FOSSASystems/FOSSASAT-2/README.md

<h1 align="center">FOSSASAT-2</h1>
<div align="center">

<i>A flexible and integrated 2P PocketQube platform designed for LEO constellations and demonstrator missions.</i>










<!-- <img src="http://hits.dwyl.com/FOSSASystems/FOSSASAT-2.svg" alt="Hits Badge"/> -->

<i>Loved the project? Please consider giving a Star ⭐️ to help it improve!</i>

</div></div>
</div>

GIF
GIF
GIF
GIF

<br>

## [Doxygen Documentation](https://fossasystems.github.io/FOSSASAT-2)

First generation 2P Satellite dedicated to demonstrating new miniaturized technology for picosatellites developed by FOSSA. Launched aboard a Firefly Alpha launch vehicle on the maiden flight with an unfortunate explosion. The satellite was recovered, and on a later launch, a FOSSASAT-1B was successfully placed in orbit by a Firefly Alpha. 

<br>
GIF 
<br>

## Payload
The main payload of FossaSat-2 is an OV2640 low-resolution CMOS camera. GSD is >50m/pixel. A Skytraq GNSS reciever is being used to test active TLE generation for PocketQubes. GPS Payload Supported by the Galileo Science office.

## ADCS
Active pointing is carried out by using integrated solar panel magnetorquers, 2 16-bit sun sensors and an IMU sensor.

## Comms
An SX1268T Chip is used to establish a Morse, 9k6 GFSK and LoRa Downlink and a LoRa and 9k6 GFSK uplink.

GIF
GIF
