FOSSASystems/FOSSASAT-2/hardware/README.md

# FOSSASAT-2 Hardware
This folder contains all schematic, layout and mechanical files related to FOSSASAT-2.
