FOSSASystems/FOSSASAT-2/software/README.md

# FOSSASAT-2 Software
This folder contains all software related to FOSSASAT-2, on-board or otherwise.
