FOSSASystems/FOSSASAT-2/hardware/Attitude Control/README.md

# ADCS

Three H-Bridges control integrated magnetorquers in each solar panel and an internal Y Axis magnetorquer. An IMU sensor on this board and external sun sensors / panel currents give attitude determination.
