FOSSASystems/FOSSASAT-2/hardware/Internal Board Stack/README.md

# Camera Board
Control FET to turn on Camera when in use.

#Battery Heater Board
Control FET to turn on a resistor when a set of conditions established in the requirements document are met.
