FOSSASystems/FOSSASAT-2/hardware/OBC/README.md

# OBC

STM32L452RE powered OBC with flash storage, SEU and SEL protection and an SX1268T Transciever.
