FOSSASystems/FOSSASAT-2/hardware/Power System/README.md

# EPS

Monitors and controls the input of solar panels, regulated to float charge a Li-Ion NP-BX1 Cell at 4V and regulates a common 3.3V power bus.
