FOSSASystems/FOSSASAT-2/hardware/Solar Panels/README.md

#Solar Panels

Solar panels include a combination of: IXYS Solar Cells, Blocking Diodes, Integrated Magnetorquers, EGSE connectors, Temperature sensors and Sun sensors.
