FOSSASystems/FOSSASAT-2/docs/Software Functional Specification.md

# FOSSASAT-2 Software Functional Specification
The purpose of this document is to keep track of all functional specifications, based on [Software Requirements](https://github.com/FOSSASystems/FOSSASAT-2/blob/master/docs/Software%20Requirements.md). Any Specification(s) that fulfill(s) Software Requirement(s) SHOULD list reference to those Requirement(s).

## Deployment Sequence
1. Once Deployed, The killswitch connects and starts  discharging to cpu or/and charging battery if in sunlight.
2. Check EEPROM if Deploy = 0, if Deploy = 1 go to System Start
3. 1m debug silent (Serial output via STLINK)
4. Satellite waits 25m in Sleep 
5. Check voltage, if under 3.7v: wait until you are charged for a maximum of 12 hours and then deploy. If above 3.7v: Deploy.
5. Send Mosfet deploymen signal 
7. Set EEPROM Deploy = 1
8. System Start

## Battery Charging and Heating
Battery heater is a mosfet control pin

1. When under 5c, battery above 3.9v and Charging current above 100mA: Turn on Battery Heater.
2. When 5c reached: turn off battery heater
3. If battery heater on and battery voltage drops below 3.8 volts: Turn off Battery Heater.
4. If battery heater off due to voltage and, temperature drops below 0c, Turn off MPPT.

## Transmissions and Reception 

## Store & Forward Repeater

## Image Downlink

## System Sleep & Power Saving System
