FOSSASystems/FOSSASAT-2/(threads)

Thread 21 (2020-07-14):

Reference frames error

SergioCdV, 2020-07-14:
In software/FossaSat2/src/ADCS/ADCS/adcs_main.cpp

https://github.com/FOSSASystems/FOSSASAT-2/blob/cfe8c75b2e419ddbf0d7e77a95fb421b0153c93a/software/FossaSat2/src/ADCS/ADCS/adcs_main.cpp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

Solar unit panel reference frame relates to the body-ADCS frame as follows: solar X+ equals ADCS X+, solar Y+ equals body Z + and finally solar Z+ equals ADCS Y+.

[ISODRAWINGFISSASAT_2.pdf](https://github.com/FOSSASystems/FOSSASAT-2/files/4919511/ISODRAWINGFISSASAT_2.pdf)

ADCS frame is the one used for naming within the code, though it is not the one used in the dynamical model. In this sense, ADCS Z+ is renamed X+, X+ goes to Y+ and ADCS Y+ ends up as Z+.

Gipsonek, 2020-07-14:
Ah, I forgot the IMU also doesn't follow the solar panel reference frame. So just to confirm, the correct conversion should be:

solar X+ = ADCS X+
solar Y+ = ADCS Z+
solar Z+ = ADCS Y+

SergioCdV, 2020-07-14:
Yes, you are right

Gipsonek, 2020-07-14:
Thank you, should be fixed in 5030998ef2a5e4d1d9dffd4de540572a26e53f45

Closed 2020-07-14.

Thread 27 (2020-07-22):

Reference frames

SergioCdV, 2020-07-22:
In adcs_main, lines 477-485, talking about the comments above, there's still a mistake when identifying reference frames (solar and ADCS). Solar X+ should be ADCS X+ and solar Z+ should be ADCS Y+.

I don't know if it is just unupdated commenting or code is to be modified also.
[
// Calculate the intensities
  // pulseLength vector follows solar panel reference frame, not ADCS frame!
  // solar X+ = ADCS Y+
  // solar Y+ = ADCS Z+
  // solar Z+ = ADCS X+
  ADCS_CALC_TYPE pulseLength[ADCS_NUM_AXES];
  pulseLength[0] = ACS_IntensitiesRectifier(adcsState.prevIntensity[0], intensity[0], adcsParams.timeStep, adcsParams.pulseAmplitude);
  pulseLength[1] = ACS_IntensitiesRectifier(adcsState.prevIntensity[2], intensity[2], adcsParams.timeStep, adcsParams.pulseAmplitude);
  pulseLength[2] = ACS_IntensitiesRectifier(adcsState.prevIntensity[1], intensity[1], adcsParams.timeStep, adcsParams.pulseAmplitude);](url)

Gipsonek, 2020-07-22:
That's just a case of forgetting to update the comments - the actual assignments are correct, i.e.

intensity[0] -> pulseLength[0] (ADCS X+ -> solar X+)
intensity[2] -> pulseLength[1] (ADCS Z+ -> solar Y+)
intensity[1] -> pulseLength[2] (ADCS Y+ -> solar Z+)

Closed 2020-07-22.

Thread 33 (2020-08-28):

Store and Forward coding

N6RFM, 2020-08-28:
Hi,

In the FS-2 sketch, message store and forwarding is supported by the folling code

case 'b':
 addStoreAndForward(0x1337BEEF, "Hello there!");
 break;

I'm not a programmer, but it appears that 0x1337BEEF is a memory address?  Is there a limit on the numberof characters which may be sent to this address?

Also, please comment on the code below.  This is intended to send a message (up to 32 characters) but unclear to me how to specify the correct memory address.

```c++
//adapted from code provided by K4KDR

String myCall="N6RFM";
String mySFtext="Hello from";

 void sendSF() {

  // get data to be stored and forwarded
  char optData[32];
  // text to transmit + some additional underscores for blank space after
  String cq = mySFtext + myCall + " ";
  // Length (with one extra character for the null terminator)
  int str_len = cq.length() + 1;
  cq.toCharArray(optData, str_len);

  Serial.println();
  Serial.print(F("Sending Store annd Forward text "));

  // data to transmit
  uint8_t functionId = CMD_STORE_AND_FORWARD_ADD;   //unclear how to specify target memory address ?0x1337BEEF
  uint8_t optDataLen = strlen(optData);

  // build frame
  uint8_t len = FCP_Get_Frame_Length(callsign, optDataLen);
  uint8_t* frame = new uint8_t[len];
  FCP_Encode(frame, callsign, functionId, optDataLen, (uint8_t*)optData);

  // send data
  int state = radio.transmit(frame, len);
  delete[] frame;
```

Thanks so much!
Bob N6RFM

Gipsonek, 2020-08-29:
0x1337BEEF is a 4-byte ID for your message, chosen by the user (see the [communication protocol specs](https://github.com/FOSSASystems/FOSSASAT-2/blob/master/docs/Communication%20Protocol.md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)). If you want to request the saved message later, you send the ID and the satellite will return the message with that ID. If you send a message with the same ID, the original one will be overwritten.

The above link also contains information on how to specify the ID (it's the first 4 bytes of optional data), as well as the maximum message length (28 bytes).

N6RFM, 2020-08-29:
Thank you for the explanation.  All Best,  Bob

Closed 2025-07-14.

Thread 36 (2025-07-28):

VEML7700-TR quality

joaosantos44, 2025-07-28:
Hello, my name is Joao Santos. I am currently working on Quetzal 2.

Your sun sensors have caught my attention, and I would like to know if they experienced any obscuration during use, as this is one of the problems we are currently facing. In the previous mission, we used photodiodes, and they did experience obscuration, which caused a drop in the voltage they were monitoring.

I look forward to your response and thank you in advance for replying to this message.
