FOSSASystems/FOSSASAT-2/hardware/OBC/Schematic_FOSSA2OBC_Sheet_1_20191107205757.pdf

PB12 33 PB13 34 PB14 35 PB15 36 PC6 37 PC7 38 PC8 39 PC9 40 PA8 41 PA9 42 PA10 43 PA11 44 PA12 45 PA13(JTMS/SWDIO) 46 VSS 47 VDDUSB 48 PA14⁽JTCK/SWCLK⁾ 49 PA15⁽JTDI) 50 PC10 51

## I2C TEMP. SENSOR

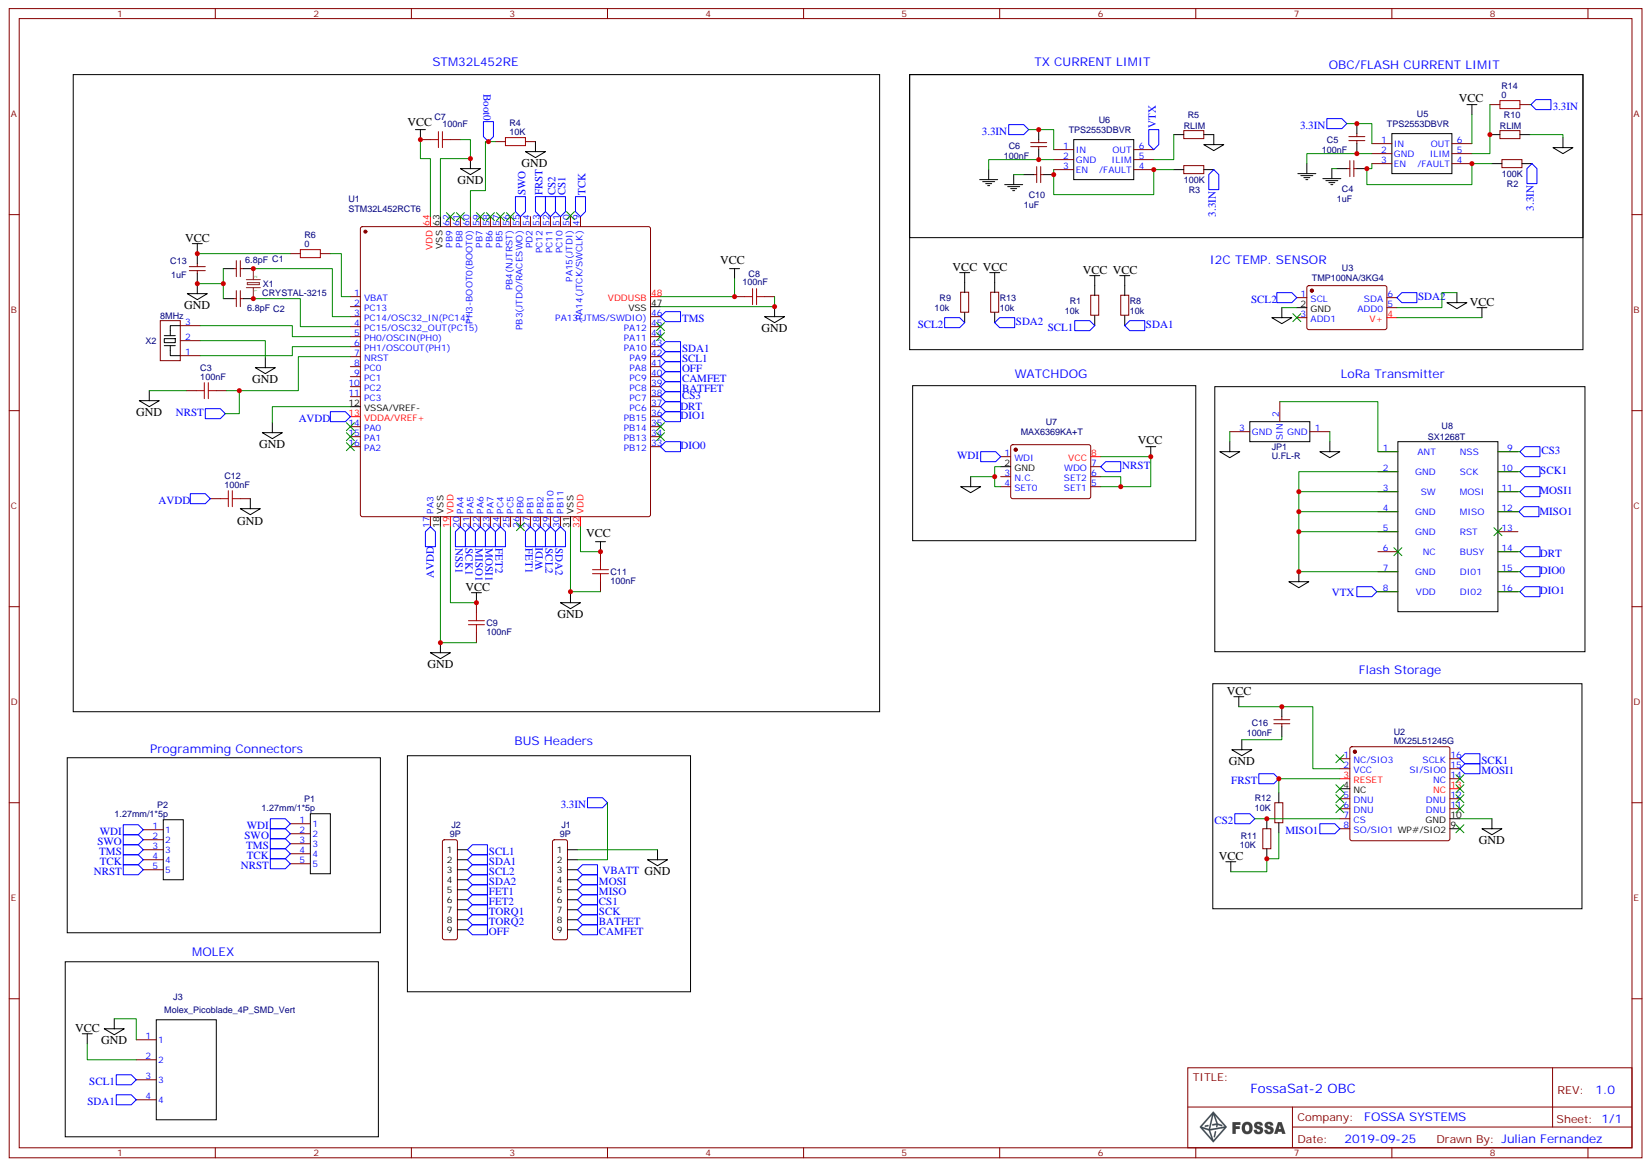
[picture p9: page 1]

OBC/FLASH CURRENT LIMIT

Drawn By: Julian Fernandez
