FOSSASystems/FOSSASAT-2/hardware/Power System/Schematic_FOSSA2MPPT_Sheet_1_20191107205719.pdf

## X AXIS PANEL MPPT

## BUS Headers

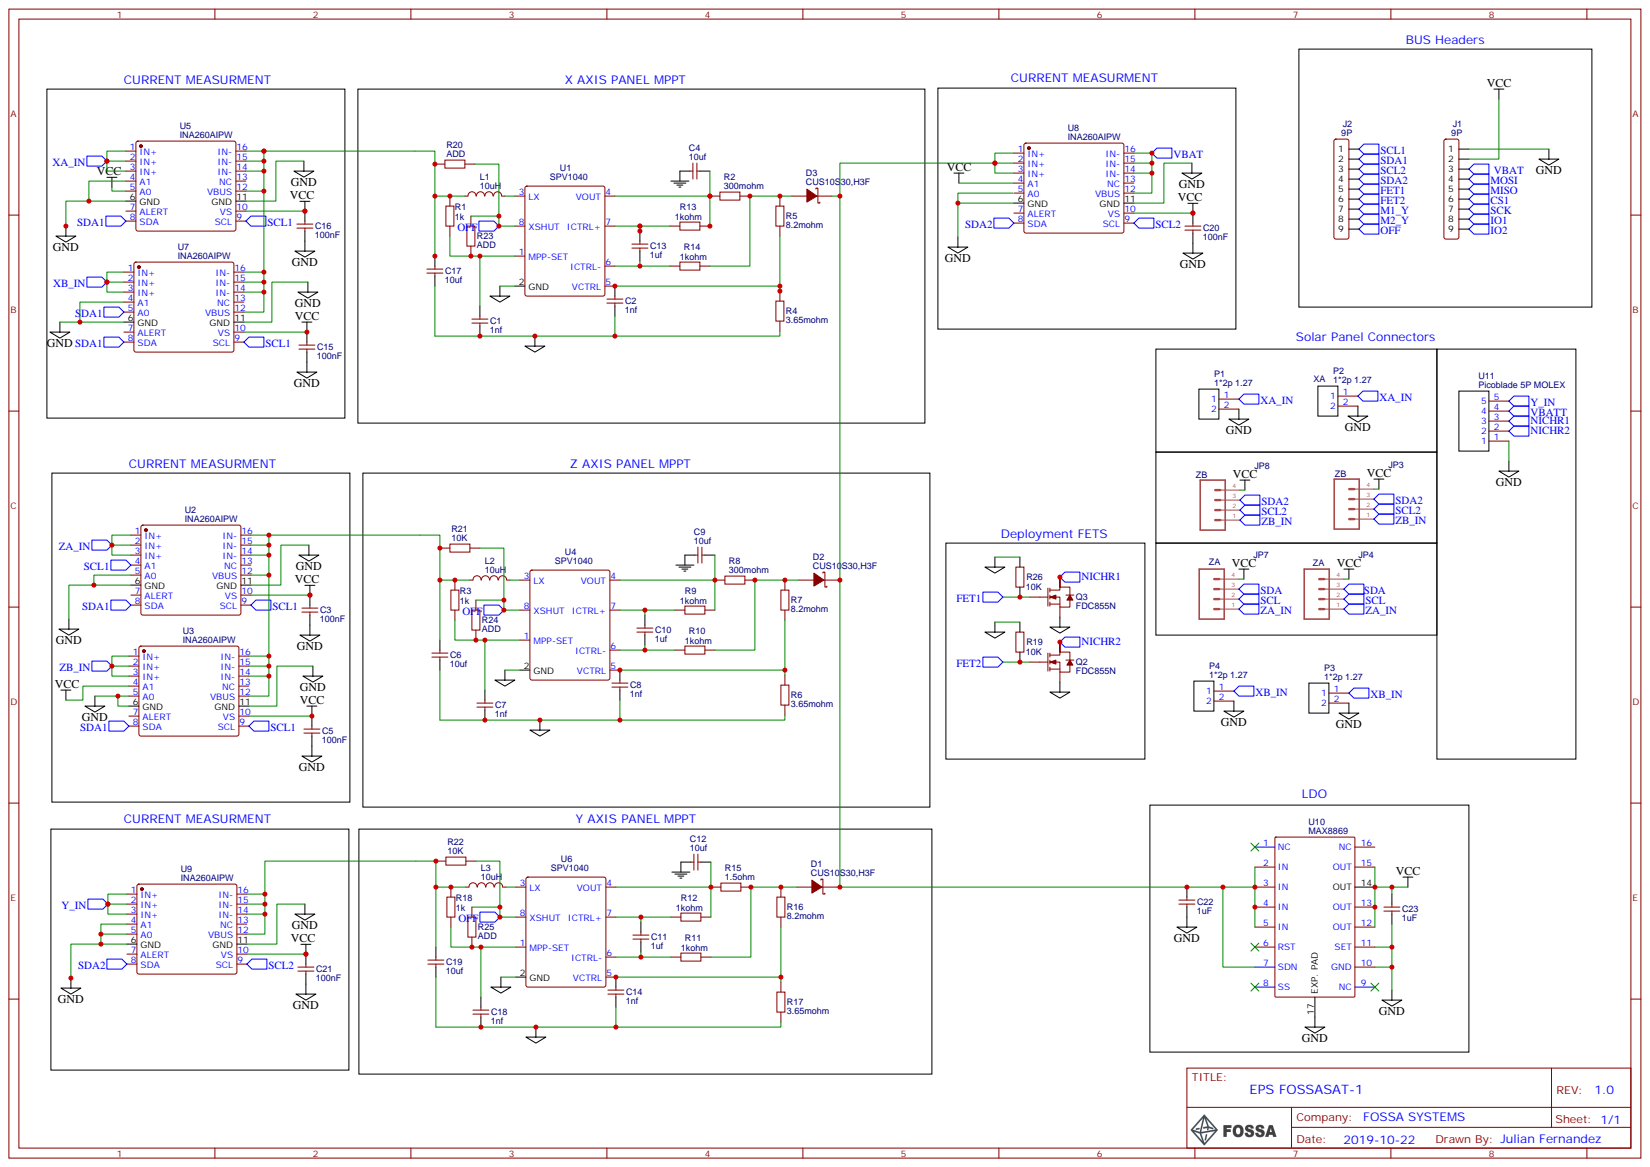
[picture p10: page 1]

INA260AIPW
VS 10 GND 11 VBUS 12 NC 13 IN- 14 IN- 15 IN- 16

Drawn By: Julian Fernandez
