FOSSASystems/FOSSASAT-2/hardware/Attitude Control/Schematic_Internal Boards FOSSASAT_1_Sheet_1_20191107210138.pdf

## BUS Headers

## Solar Panel Headers

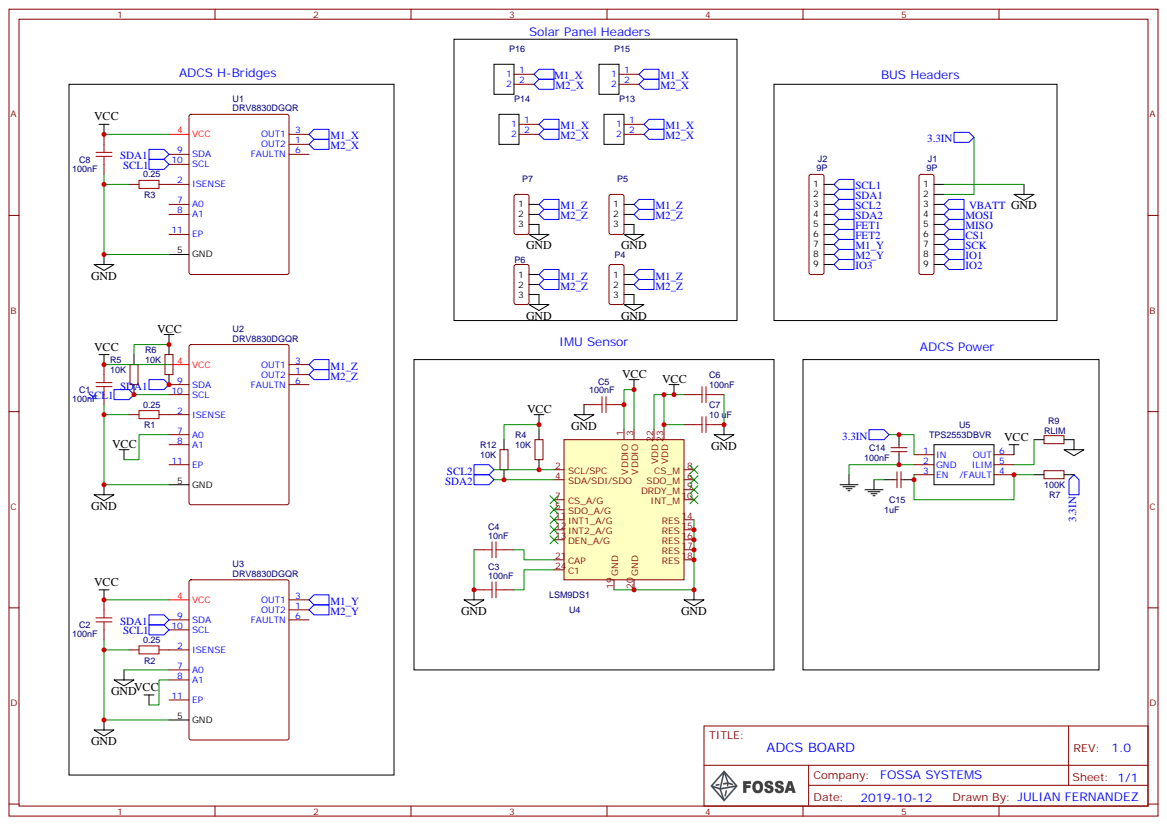
[picture p11: page 1]

Drawn By: JULIAN FERNANDEZ
