FOSSASystems/FOSSASAT-2/hardware/Internal Board Stack/Schematic_battboard_Sheet_1_20191107204911.pdf

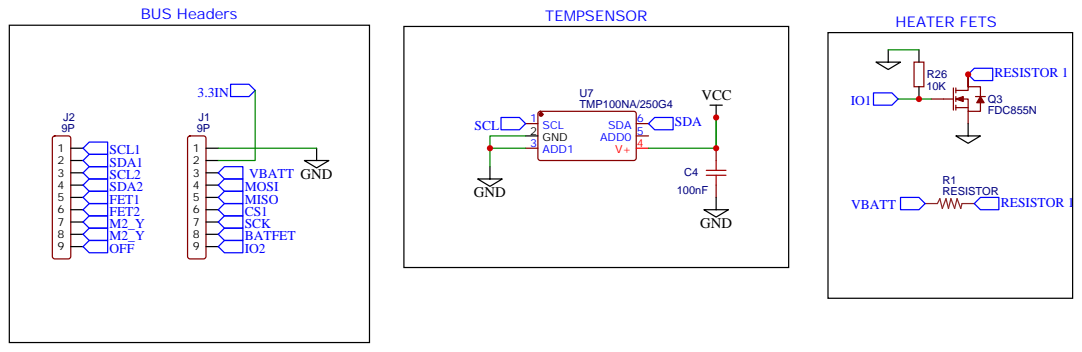
[picture p12: page 1]

Drawn By: Julian Fernandez
