FOSSASystems/FOSSASAT-2/hardware/Internal Board Stack/Schematic_ov2640_Sheet_1_20191107205330.pdf

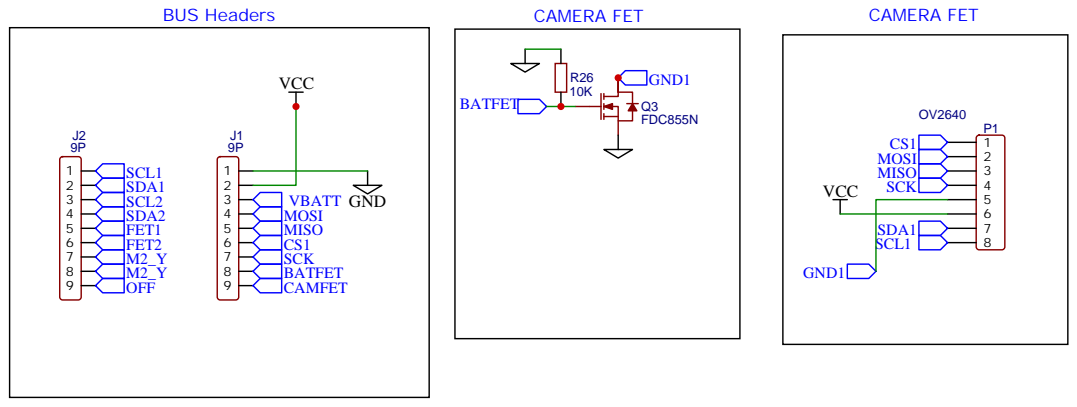
[picture p13: page 1]
