FOSSASystems/FOSSASAT-2/hardware/Solar Panels/Schematic_Antenna_Panel_Sheet_1_20191107205026.pdf

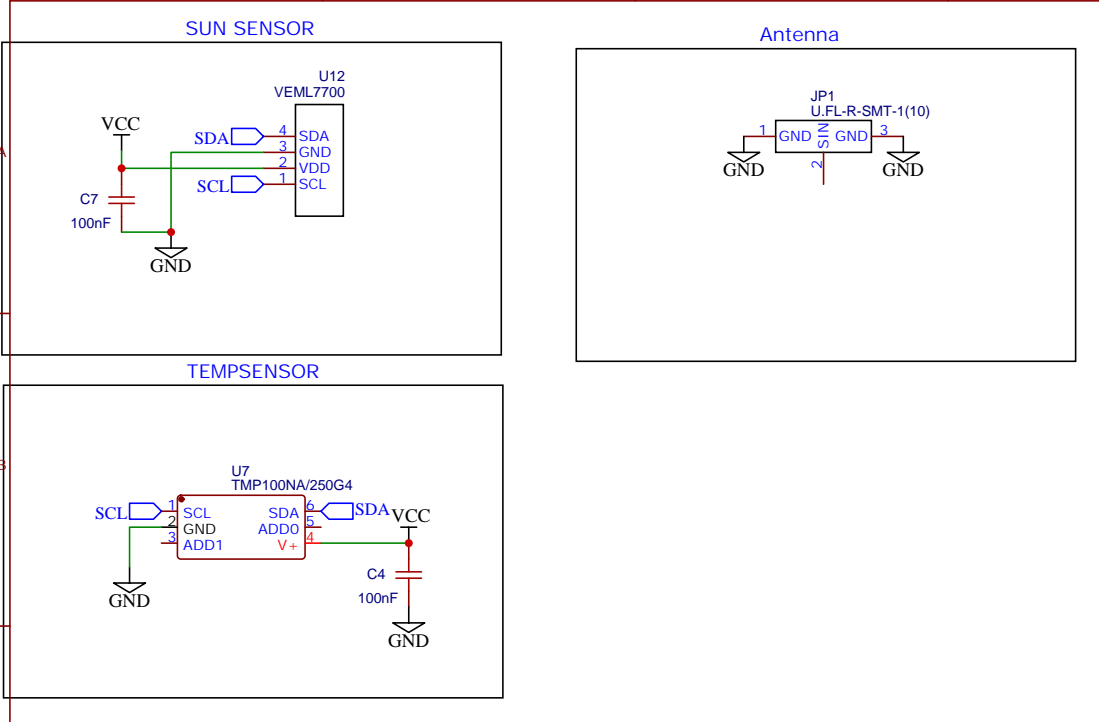
[picture p14: page 1]

Drawn By: Julian Fernandez
