FOSSASystems/FOSSASAT-2/hardware/Solar Panels/Schematic_FOSSASAT-2 SOLAR PANELS_Sheet_1_20191107205555.pdf

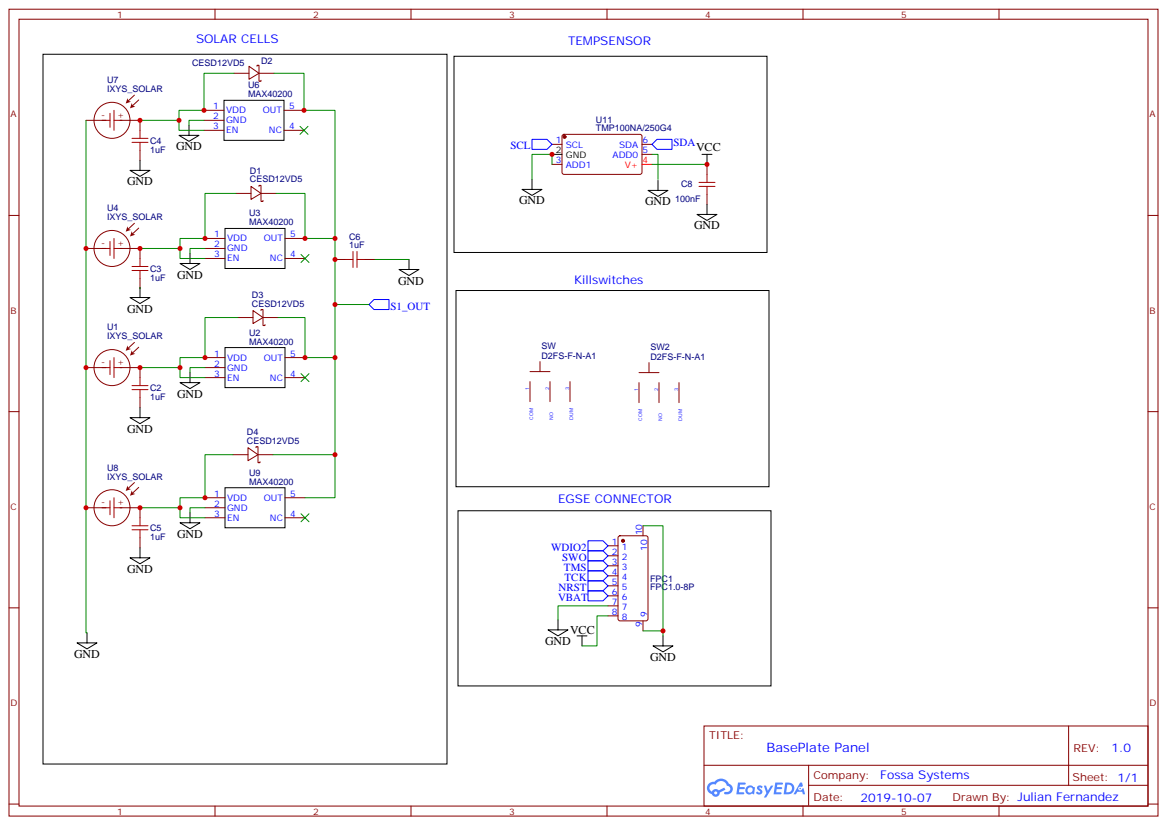
[picture p15: page 1]

Drawn By: Julian Fernandez
