FOSSASystems/FOSSASAT-2/hardware/Solar Panels/Schematic_SidePanels_FOSSA_Sheet_1_20191107205156.pdf

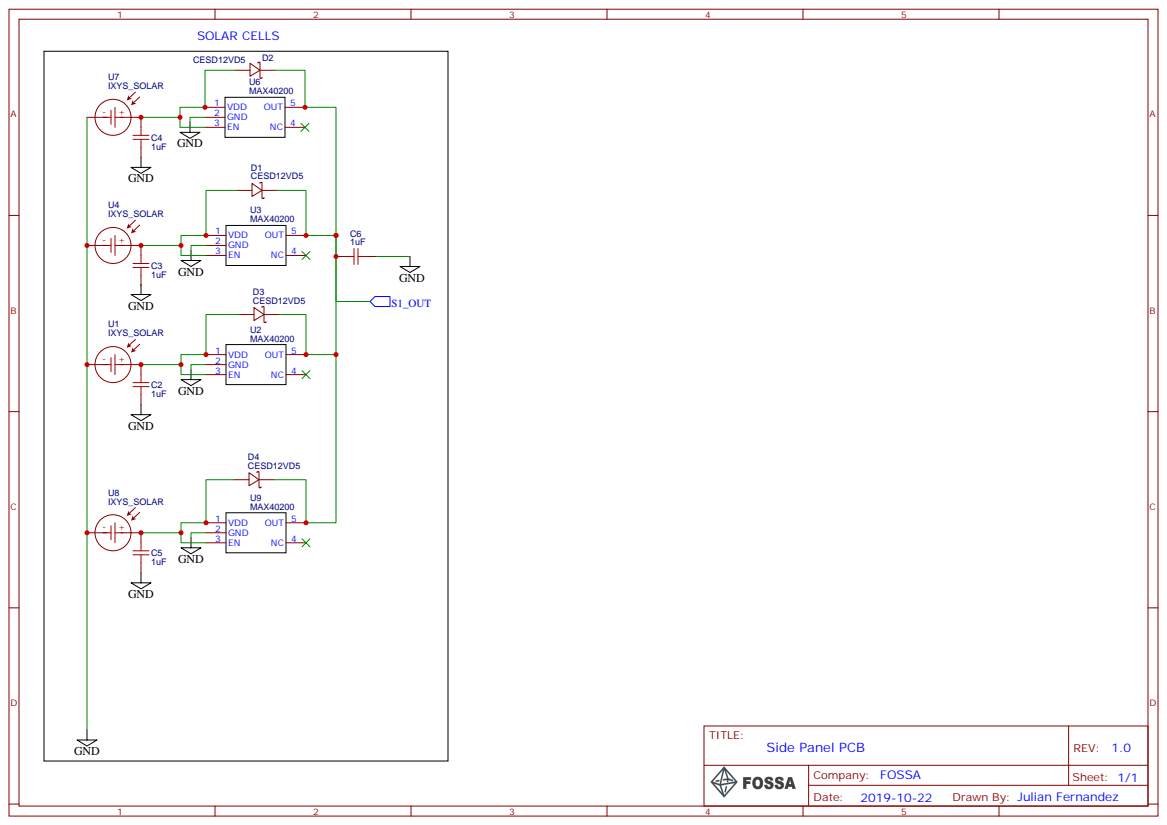
[picture p16: page 1]

Drawn By: Julian Fernandez
