FOSSASystems/FOSSASAT-2/hardware/Solar Panels/Schematic_top_panel_Sheet_1_20191107210018.pdf

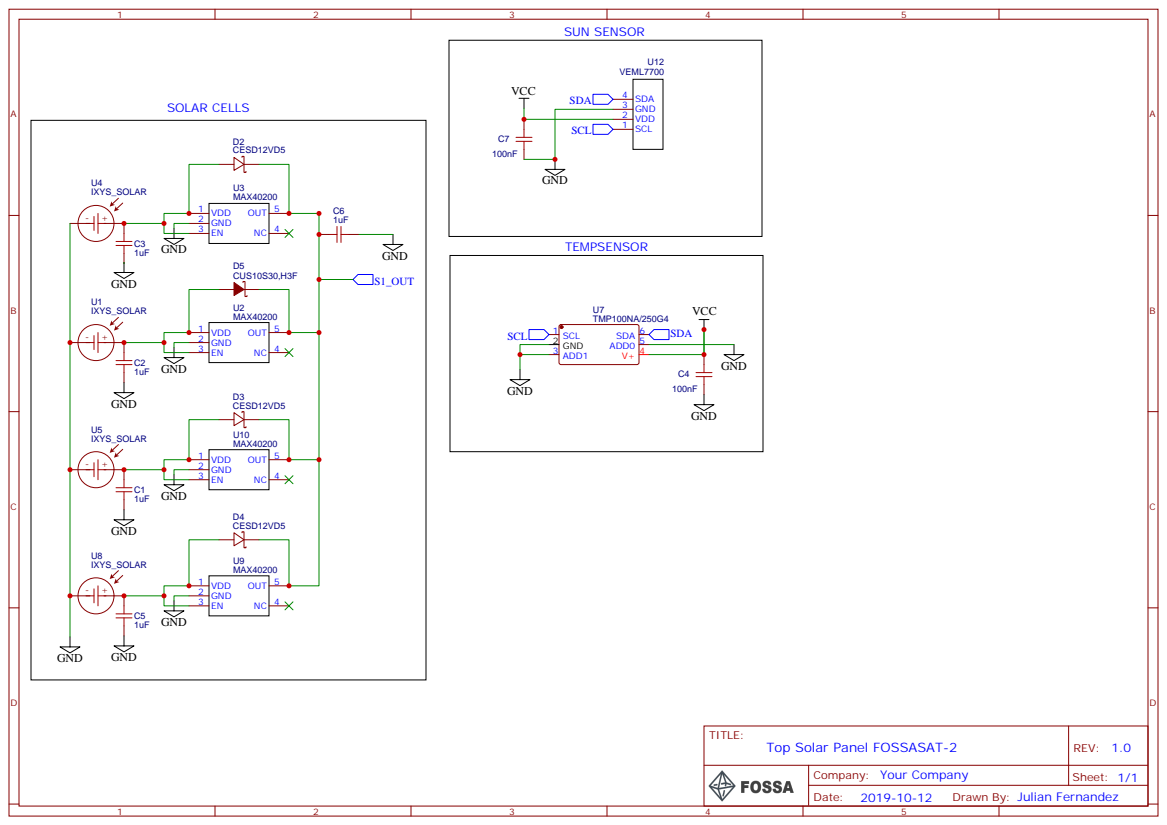
[picture p17: page 1]

Drawn By: Julian Fernandez
