FOSSASystems/FOSSASAT-2/software/FossaSat2/src/Debug.h

#ifndef _FOSSASAT_DEBUG_H
#define _FOSSASAT_DEBUG_H

#include "FossaSat2.h"

extern HardwareSerial debugSerial;

// uncomment to enable debug output
// RadioLib debug can be enabled in RadioLib/src/TypeDef.h
#define FOSSASAT_DEBUG

#define FOSSASAT_DEBUG_PORT   debugSerial
#define FOSSASAT_DEBUG_SPEED  9600

#define STR(VAR) (#VAR)

#ifdef FOSSASAT_DEBUG
#define FOSSASAT_DEBUG_BEGIN(...) { FOSSASAT_DEBUG_PORT.begin(__VA_ARGS__); delay(500); while(!FOSSASAT_DEBUG_PORT); }
#define FOSSASAT_DEBUG_PRINT(...) { FOSSASAT_DEBUG_PORT.print(__VA_ARGS__); }
#define FOSSASAT_DEBUG_PRINTLN(...) { FOSSASAT_DEBUG_PORT.println(__VA_ARGS__); }
#define FOSSASAT_DEBUG_WRITE(...) { FOSSASAT_DEBUG_PORT.write(__VA_ARGS__); }
#define FOSSASAT_DEBUG_PRINT_BUFF(BUFF, LEN) { \
    for(size_t i = 0; i < LEN; i++) { \
      FOSSASAT_DEBUG_PORT.print(F("0x")); \
      FOSSASAT_DEBUG_PORT.print(BUFF[i], HEX); \
      FOSSASAT_DEBUG_PORT.print('\t'); \
      FOSSASAT_DEBUG_PORT.write(BUFF[i]); \
      FOSSASAT_DEBUG_PORT.println(); \
    } }
#define FOSSASAT_DEBUG_PRINT_FLASH(ADDR, LEN) { \
    uint8_t readBuff[FLASH_EXT_PAGE_SIZE]; \
    PersistentStorage_Read(ADDR, readBuff, LEN); \
    char buff[16]; \
      for(size_t i = 0; i < (LEN)/16; i++) { \
        for(uint8_t j = 0; j < 16; j++) { \
          sprintf(buff, "%02x ", readBuff[i*16 + j]); \
          FOSSASAT_DEBUG_PORT.print(buff); \
        } \
        FOSSASAT_DEBUG_PORT.println(); \
      } \
      for(size_t i = (((LEN)/16) * 16); i < (LEN); i++) { \
        sprintf(buff, "%02x ", readBuff[i]); \
        FOSSASAT_DEBUG_PORT.print(buff); \
      } \
      FOSSASAT_DEBUG_PORT.println(); \
    }
#define FOSSASAT_DEBUG_PRINT_RTC_TIME() { \
    FOSSASAT_DEBUG_PORT.print(rtc.getHours()); \
    FOSSASAT_DEBUG_PORT.print(':'); \
    FOSSASAT_DEBUG_PORT.print(rtc.getMinutes()); \
    FOSSASAT_DEBUG_PORT.print(':'); \
    FOSSASAT_DEBUG_PORT.println(rtc.getSeconds()); \
  }
#define FOSSASAT_DEBUG_DELAY(MS) { delay(MS); }
#define FOSSASAT_DEBUG_PRINT_ADCS_VECTOR(VECTOR, SIZE) { \
  FOSSASAT_DEBUG_PRINT(STR(VECTOR)); \
  FOSSASAT_DEBUG_PRINT(F("=\t\t")); \
  for(uint8_t i = 0; i < SIZE; i++) { \
    FOSSASAT_DEBUG_PRINT(VECTOR[i], 6); FOSSASAT_DEBUG_PRINT('\t'); \
  } \
  FOSSASAT_DEBUG_PRINTLN(); \
}
#define FOSSASAT_DEBUG_PRINT_ADCS_MATRIX(MATRIX, ROWS, COLS) { \
  FOSSASAT_DEBUG_PRINTLN(STR(MATRIX)); \
  for(uint8_t row = 0; row < ROWS; row++) { \
    for(uint8_t col = 0; col < COLS; col++) { \
      FOSSASAT_DEBUG_PRINT(MATRIX[row][col], 6); \
      FOSSASAT_DEBUG_PRINT('\t'); \
    } \
    FOSSASAT_DEBUG_PRINTLN(); \
  } \
  FOSSASAT_DEBUG_PRINTLN(); \
}
#else
#define FOSSASAT_DEBUG_BEGIN(...) {}
#define FOSSASAT_DEBUG_PRINT(...) {}
#define FOSSASAT_DEBUG_PRINTLN(...) {}
#define FOSSASAT_DEBUG_WRITE(...) {}
#define FOSSASAT_DEBUG_PRINT_BUFF(BUFF, LEN) {}
#define FOSSASAT_DEBUG_PRINT_FLASH(ADDR, LEN) {}
#define FOSSASAT_DEBUG_PRINT_RTC_TIME() {}
#define FOSSASAT_DEBUG_DELAY(MS) {}
#define FOSSASAT_DEBUG_PRINT_ADCS_VECTOR(VECTOR, SIZE) {}
#define FOSSASAT_DEBUG_PRINT_ADCS_MATRIX(MATRIX, ROWS, COLS) {}
#endif

#endif
