FOSSASystems/FOSSASAT-2/software/FossaSat2/src/ADCS/ACS/intensities_filter.cpp

/* Project: FossaSat-2 Flight Software
   Author: Team Steiner
   Module: adcs.h
   File: intensities_rectifier.c
   04/30/20

   This file drives the intensity rectifier filter to implement a pulse-modulated
   control law by means of a modified trapezoidal rule integration scheme
*/

/************** Headers ****************/
#include "../ADCS/adcs.h"

/**************** Main function ***********/
ADCS_CALC_TYPE ACS_IntensitiesRectifier(const ADCS_CALC_TYPE intensity1, const ADCS_CALC_TYPE intensity2, const uint32_t delta_t, const ADCS_CALC_TYPE amplitude) {
  // Energy approximation of the signal by the trapezoidal rule
  ADCS_CALC_TYPE intensityDiff = intensity2 - intensity1;
  ADCS_CALC_TYPE energy = (pow(intensity1, 2.0) + (pow(intensityDiff, 2.0) / 3.0) + abs(intensity1*intensityDiff)) * (ADCS_CALC_TYPE)delta_t;

  // Pulse time calculation
  ADCS_CALC_TYPE duration = energy/pow(amplitude, 2.0);
  if (intensity2 < 0) {
    duration *= -1.0;
  }

  return(duration);
}
