FOSSASystems/FOSSASAT-2/software/TestSketches/CameraPhoto/src/Camera.cpp

#include "Camera.h"

uint8_t Camera_Init(JPEG_Size pictureSize, Light_Mode lightMode, Color_Saturation saturation, Brightness brightness, Contrast contrast, Special_Effects special) {
  // check provided values
  if(!((pictureSize >= p160x120) && (pictureSize <= p1600x1200))) {
    FOSSASAT_DEBUG_PRINT(F("Error - invalid picture size: "));
    FOSSASAT_DEBUG_PRINTLN(pictureSize);
    return 1;
  }
  
  if(!((lightMode >= Auto) && (lightMode <= Home))) {
    FOSSASAT_DEBUG_PRINT(F("Error - invalid light mode: "));
    FOSSASAT_DEBUG_PRINTLN(lightMode);
    return 2;
  }
  
  if(!((saturation >= Saturation2) && (saturation <= Saturation_2))) {
    FOSSASAT_DEBUG_PRINT(F("Error - invalid saturation: "));
    FOSSASAT_DEBUG_PRINTLN(saturation);
    return 3;
  }
  
  if(!((brightness >= Brightness2) && (brightness <= Brightness_2))) {
    FOSSASAT_DEBUG_PRINT(F("Error - invalid brightness: "));
    FOSSASAT_DEBUG_PRINTLN(brightness);
    return 4;
  }
  
  if(!((contrast >= Contrast2) && (contrast <= Contrast_2))) {
    FOSSASAT_DEBUG_PRINT(F("Error - invalid contrast: "));
    FOSSASAT_DEBUG_PRINTLN(contrast);
    return 5;
  }
  
  if(!((special >= Antique) && (special <= Normal))) {
    FOSSASAT_DEBUG_PRINT(F("Error - invalid special effect: "));
    FOSSASAT_DEBUG_PRINTLN(special);
    return 6;
  }
  
  FOSSASAT_DEBUG_PRINT(F("Picture size: "));
  FOSSASAT_DEBUG_PRINTLN(pictureSize);
  
  // reset CPLD
  camera->write_reg(0x07, 0x80);
  PowerControl_Wait(500);
  camera->write_reg(0x07, 0x00);
  PowerControl_Wait(500);

  // check camera SPI
  uint32_t start = millis();
  uint8_t state = 0;
  while(millis() - start <= 5000) {
    PowerControl_Watchdog_Heartbeat();
    
    // write to test register
    camera->write_reg(ARDUCHIP_TEST1, 0x55);

    // read the value back
    uint8_t testValue = camera->read_reg(ARDUCHIP_TEST1);
    if(testValue != 0x55){
      FOSSASAT_DEBUG_PRINT(F("Camera SPI test failed, got 0x"));
      FOSSASAT_DEBUG_PRINTLN(testValue, HEX);
      state = 7;
      
    } else {
      FOSSASAT_DEBUG_PRINTLN(F("Camera SPI test OK"));
      state = 0;
      break;
    }
    
    PowerControl_Wait(500);
  }

  if(state != 0) {
    return(state);
  }

  // check camera I2C
  start = millis();
  while(millis() - start <= 5000) {
    uint8_t vid = 0;
    uint8_t pid = 0;
    camera->wrSensorReg8_8(0xff, 0x01);
    camera->rdSensorReg8_8(OV2640_CHIPID_HIGH, &vid); //CD
    camera->rdSensorReg8_8(OV2640_CHIPID_LOW, &pid);  //CD
    if(vid != 0x26) {
      FOSSASAT_DEBUG_PRINTLN(F("Unexpected vendor ID!"));
      FOSSASAT_DEBUG_PRINT(F("Expected 0x26, got 0x"));
      FOSSASAT_DEBUG_PRINTLN(vid, HEX);
      state = 8;
    } else if(!((pid == 0x41) || (pid == 0x42))) {
      FOSSASAT_DEBUG_PRINTLN(F("Unexpected product ID!"));
      FOSSASAT_DEBUG_PRINT(F("Expected 0x41/0x42, got 0x"));
      FOSSASAT_DEBUG_PRINTLN(pid, HEX);
      state = 9;
    } else {
      FOSSASAT_DEBUG_PRINTLN(F("Detected OV2640"));
      state = 0;
      break;
    }
    
    PowerControl_Wait(500);
  }

  if(state != 0) {
    return(state);
  }
  
  // set JPEG mode and initialize
  camera->SetFormat(JPEG_FMT);
  camera->InitCAM();

  // set size
  camera->SetJPEGsize(pictureSize);
  PowerControl_Wait(1000);
  camera->clear_fifo_flag();

  // set the rest of parameters
  camera->SetLightMode(lightMode);
  camera->SetColorSaturation(saturation);
  camera->SetBrightness(brightness);
  camera->SetContrast(contrast);
  camera->SetSpecialEffects(special);

  return(state);
}

uint32_t Camera_Capture(uint8_t slot) {
  // flush FIFO
  camera->flush_fifo();
  camera->clear_fifo_flag();
  
  // start capture
  FOSSASAT_DEBUG_PRINTLN(F("Capture start."));
  camera->start_capture();

  // wait for capture done
  uint32_t start = millis();
  while(!camera->get_bit(ARDUCHIP_TRIG, CAP_DONE_MASK)) {
    PowerControl_Wait(500);
    if(millis() - start >= 5000) {
      FOSSASAT_DEBUG_PRINTLN(F("Timed out waiting for capture end!"));
      return(0x00000000);
    }
  }

  // read image length
  FOSSASAT_DEBUG_PRINTLN(F("Capture done, reading data."));
  uint32_t len = camera->read_fifo_length();
  uint32_t scanStart = 0x00000000;
  uint32_t scanEnd = 0x00000000;
  if(len >= MAX_FIFO_SIZE) {
    FOSSASAT_DEBUG_PRINT(F("Image size is too large ("));
    FOSSASAT_DEBUG_PRINT(len)
    FOSSASAT_DEBUG_PRINTLN(F(" B)!"));
    return(0xFFFFFFFF);
  } else if(len == 0) {
    FOSSASAT_DEBUG_PRINTLN(F("Image size is 0 B!"));
    return(0x00000000);
  }

  // print some basic info
  FOSSASAT_DEBUG_PRINT(F("Image size (bytes): "));
  FOSSASAT_DEBUG_PRINTLN(len);
  FOSSASAT_DEBUG_PRINT(F("Using slot: "));
  FOSSASAT_DEBUG_PRINTLN(slot);
  FOSSASAT_DEBUG_PRINT(F("Starting at address: 0x"));
  uint32_t imgAddress = FLASH_IMAGES_START + slot*FLASH_IMAGE_SLOT_SIZE;
  FOSSASAT_DEBUG_PRINTLN(imgAddress, HEX);

  // erase image blocks in flash
  for(uint32_t i = 0; i < FLASH_IMAGE_NUM_64K_BLOCKS; i++) {
    PersistentStorage_64kBlockErase(imgAddress + i*FLASH_64K_BLOCK_SIZE);
    PowerControl_Watchdog_Heartbeat();
  }

  // read data and write them to flash
  digitalWrite(CAMERA_CS, LOW);
  camera->set_fifo_burst();

  // write the complete pages first
  uint8_t dataBuffer[FLASH_EXT_PAGE_SIZE];
  uint32_t i;
  uint8_t prevByte = 0x00;
  for(i = 0; i < len / FLASH_EXT_PAGE_SIZE; i++) {
    for(uint32_t j = 0; j < FLASH_EXT_PAGE_SIZE; j++) {
      // get the new byte
      uint8_t newByte = SPI.transfer(0x00);

      // save addresses of JPEG markers
      if(prevByte == JPEG_MARKER_ESCAPE) {
        switch(newByte) {
          case JPEG_MARKER_SOF0:
            scanStart = imgAddress + i*FLASH_EXT_PAGE_SIZE + j + 1;
            break;
          case JPEG_MARKER_EOI:
            scanEnd = imgAddress + i*FLASH_EXT_PAGE_SIZE + j - 1;
            break;
        }
      }

      // update buffer and cache
      dataBuffer[j] = newByte;
      prevByte = newByte;
    }

    // write a single sector
    PersistentStorage_Write(imgAddress + i*FLASH_EXT_PAGE_SIZE, dataBuffer, FLASH_EXT_PAGE_SIZE, false);
  }

  // write the remaining page
  uint32_t remLen = len - i*FLASH_EXT_PAGE_SIZE;
  for(uint32_t j = 0; j < remLen; j++) {
      // get the new byte
      uint8_t newByte = SPI.transfer(0x00);

      // save addresses of JPEG markers
      if(prevByte == JPEG_MARKER_ESCAPE) {
        switch(newByte) {
          case JPEG_MARKER_SOF0:
            scanStart = imgAddress + i*FLASH_EXT_PAGE_SIZE + j + 1;
            break;
          case JPEG_MARKER_EOI:
            scanEnd = imgAddress + i*FLASH_EXT_PAGE_SIZE + j - 1;
            break;
        }
      }

      // update buffer and cache
      dataBuffer[j] = newByte;
      prevByte = newByte;
  }
  PersistentStorage_Write(imgAddress + i*FLASH_EXT_PAGE_SIZE, dataBuffer, remLen, false);

  // write image properties
  FOSSASAT_DEBUG_PRINT(F("Scan start: 0x"));
  FOSSASAT_DEBUG_PRINTLN(scanStart, HEX);
  FOSSASAT_DEBUG_PRINT(F("Scan end: 0x"));
  FOSSASAT_DEBUG_PRINTLN(scanEnd, HEX);
  PersistentStorage_Set_Image_Properties(slot, len, scanStart, scanEnd);
  
  FOSSASAT_DEBUG_PRINTLN(F("Writing done"));
  
  digitalWrite(CAMERA_CS, HIGH);
  camera->clear_fifo_flag();
  return(len);
}
