FOSSASystems/FOSSASAT-2/(commit log)

2019-10-19 Added I2C address map
2019-10-27 Added STM32 libraries
2019-10-27 Update I2C Address Map.md
2019-11-07 Added Hardware Schematics
2019-11-08 Initial software commit
    [Configuration.h]
2019-11-10 Updated formatting
    [Configuration.h]
2019-11-10 Added FS-1 private frames
2019-11-17 Using correct I2C bus for IMU
    [Configuration.h]
2019-11-17 Added more data to system info frame
2019-11-27 Updated for RadioLib 2.0.0
    [Configuration.h]
2019-12-04 Added camera control
    [Configuration.h]
2020-01-24 Implemented external flash control
    [Configuration.h]
2020-01-24 Added missing call to update
    [InertialMeasurementUnit.ino]
2020-01-24 Added missing SPI begin
    [Configuration.cpp]
2020-01-24 Changed flash get/set to use templates
    [Configuration.h]
2020-01-24 Implemented persistent storage only in external flash
    [Configuration.h]
2020-01-25 Fixed flash reset pin
    [PersistentStorage.cpp]
2020-01-25 Fixed flash reset pin mode
    [Configuration.cpp]
2020-01-27 Added i2c scanner
2020-01-27 Ported 1B code and checked all sensors
    [Configuration.h]
2020-01-28 Moved image length to system info block in flash
    [Configuration.h]
2020-01-28 Removed dupliacte macro
    [Configuration.h]
2020-01-28 Disabled camera by default
2020-01-28 Added missing low power enable command
    [Communication.cpp]
2020-01-28 Added camera capture command
2020-01-28 Added ground station demo sketch
2020-01-28 Fixed incorrect radio type
    [Configuration.h]
2020-01-28 Fixed incorrect default encryption key
    [Configuration.cpp]
2020-01-28 Unified flash address names
    [Configuration.h]
2020-01-28 Updated external flash test
    [Configuration.h]
2020-01-29 Added debug function to print flash contents
2020-01-29 Renamed low power macro
2020-01-29 Fixed missing spreading factor configuration
    [Communication.cpp]
2020-01-29 Added option to set camera properties
    [Configuration.h]
2020-01-29 Updated pin mapping
    [Configuration.h]
2020-01-29 Fixed incorrect sector erase
    [Configuration.h]
2020-01-29 Added battery heater and sleep interval control
2020-01-29 Renamed FLASH_PAGE_SIZE macro (confilcts with STM32 HAL
    [Configuration.h]
2020-01-29 Implemented configurable power limits
    [Configuration.h]
2020-01-29 Implemented MPPT keep alive and temp switch control
    [Configuration.h]
2020-01-29 Implemented wipe for all storages
    [Configuration.h]
2020-01-30 Updated flash test
    [Configuration.h]
2020-01-30 Fixed missing modem restore on override
    [Communication.cpp]
2020-01-30 Added missing timeout for flash erase
    [PersistentStorage.cpp]
2020-01-30 Fixed flash map
    [Configuration.h]
2020-01-30 Added argument to skip battery management in watchdog heartbeat
    [PowerControl.cpp, PowerControl.h]
2020-01-30 Fixed incorrect timeout type
    [PersistentStorage.cpp, PersistentStorage.h]
2020-01-30 Fixed imagle lengths in slots above 63
    [PersistentStorage.cpp]
2020-01-30 Added RTC
    [Configuration.h]
2020-01-30 Added timeout to RTC configuration prompt
    [Configuration.h]
2020-01-30 Added epoch to flash
    [Configuration.h]
2020-01-30 Removed unused flash variable
    [Configuration.h]
2020-01-30 Added power config to system info frame
2020-01-30 Added method to update all stats
    [Configuration.h]
2020-01-30 Implemented stats request
    [Configuration.h]
2020-01-31 Added missing null temrinator
    [PersistentStorage.cpp]
2020-01-31 Implemented IMU recording
2020-01-31 Fixed incorrect function ID
    [Communication.cpp]
2020-02-01 Implemented burst picture downlink
    [Configuration.h]
2020-02-01 Added battery check to picture reading
2020-02-02 Added flash display sketch
    [Configuration.h]
2020-02-02 Implemented GPS logging
    [Configuration.h]
2020-02-03 Fixed private command limit check
    [Communication.cpp]
2020-02-03 Added check for empty picture slot in downlink request
2020-02-03 Fixed writing over flash page border
    [Communication.cpp, PersistentStorage.cpp]
2020-02-03 Fixed analog input blocking some GPIO outputs
    [Configuration.cpp]
2020-02-03 Removed external wakeup (prevents UART4 from working)
    [Communication.cpp, FossaSat2.ino]
2020-02-03 Only sending full system info GFSK when not in low power mode
2020-02-03 Added new function IDs to ground station
2020-02-03 Fixed incorrect type width
    [Communication.cpp]
2020-02-03 Reworked GPS logging to save log entries in 128 chunks separately
    [Communication.cpp]
2020-02-03 Extended GPS log area to 6 64k blocks
    [Configuration.h]
2020-02-04 Changed PRNG seed pin to PC2
    [Configuration.h]
2020-02-04 Updated test sketches
    [Configuration.h]
2020-02-04 Added picture upload sketch
    [Configuration.h]
2020-02-04 Fixed incorrect optional data length check
    [Communication.cpp]
2020-02-04 Implemented store and forward
    [Configuration.h]
2020-02-04 Reworked store and forward
    [Configuration.h]
2020-02-04 Fixed store and forward length logging
    [Communication.cpp]
2020-02-06 Added Flash wipe sketch
    [Configuration.h]
2020-02-09 Fixed incorrect debug macro value
    [Configuration.h]
2020-02-09 Fixed typo in variable name
    [Communication.cpp]
2020-02-09 Added SystemInfoSerial test sketch
    [Configuration.h]
2020-02-12 Increased NMEA log size
    [Configuration.h]
2020-02-14 Fixed debug port when using HardwareSerial
    [Configuration.h]
2020-02-23 Fixed possible buffer overflow
    [Communication.cpp]
2020-02-23 Attempt to fix unused cppcheck warnings
    [Communication.cpp]
2020-03-23 Set whitening initial to 0x1FF for SX127x compatibility
    [Configuration.h]
2020-04-15 Changed camera library
    [Configuration.h]
2020-05-07 Added frame ACK to test specification
2020-05-07 Added automated statistics transmission
    [Configuration.h]
2020-05-07 Fixed system info flash page length
    [PersistentStorage.h]
2020-05-08 Implemented CRC32 for system info flash page
    [Configuration.h]
2020-05-08 Added system info page error counter
    [Configuration.h]
2020-05-09 Implemented TLE uplink command
    [Configuration.h]
2020-05-10 Added light sensor overflow check
2020-05-10 Fixed stats reset
    [Configuration.h]
2020-05-11 Simplified stats printing
2020-05-11 Simplified flash stats update
    [Configuration.h]
2020-05-12 Added option to create memory error from ground station
    [Communication.cpp, GroundStation.ino]
2020-05-13 Implemented GPS log downlink newest first
    [Configuration.h]
2020-05-14 Disabled GPS UART when not in use
2020-05-15 Added missing camera params
    [Camera.cpp]
2020-05-17 Fixed incorrect I2C addresses in IMU test
    [InertialMeasurementUnit.ino]
2020-05-18 Fixed incorrect Hbridge I2C address
    [HBridges.ino]
2020-05-18 Fixed incorrect temperature sensor address
    [TemperatureSensors.ino]
2020-05-18 Fixed incorrect current sensor address
    [CurrentSensors.ino]
2020-05-18 Fixed IMU initialization
2020-05-19 Updated SystemInfoSerial test for current flight code
    [Configuration.h]
2020-05-20 Fixed incorrect packet length
    [OutputPower.ino]
2020-05-21 Set FSK frequency to 436.9 MHz
    [Configuration.h]
2020-05-21 Removed redundant value check (root cause resolved)
    [Sensors.cpp]
2020-05-21 Changed parameter to LoRa frequency
    [Configuration.h]
2020-05-21 Fixed current unit
2020-05-22 Fixed swapped Hbridge addresses for Y and Z axes
    [Configuration.h]
2020-05-22 fixed addresses
    [Configuration.h]
2020-05-22 Added Hbridge stop on reset
    [FossaSat2.ino]
2020-05-22 Fixed sleep length in Rx
    [FossaSat2.ino]
2020-05-23 Added CMD_GET_GPS_LOG_STATE and last GPS fix logging
    [Configuration.h]
2020-05-23 Fixed sleep step size (1000 ms minimum)
    [Communication.cpp, FossaSat2.ino, PowerControl.cpp]
2020-05-23 Added new commands to ground station demo
2020-05-24 Added watchdog heartbeat when wiping image slot
2020-05-24 Updated expected deployment time
    [Configuration.h]
2020-05-24 Set deployment sleep length to 30 mins
    [Configuration.h]
2020-05-24 Set MPPT temperature limit to -0.7 deg. C
    [Configuration.h]
2020-05-24 Updated light sensors gain and integration time
    [Configuration.h]
2020-05-24 Disabled Morse beacon preamble
    [Configuration.h]
2020-05-24 Removed shutdown low power mode
2020-05-24 Fixed cppcheck style warning (unsigned less than 0)
    [Communication.cpp]
2020-05-24 Added MCU temperature sensor
    [Configuration.h]
2020-05-24 Fixed incorrect macro name
    [PowerControl.cpp]
2020-05-25 Added MCU temperature parsing
2020-05-25 Implemented Morse beacon every 2nd loop only
    [Configuration.h]
2020-05-25 Implemented RAM buffer for system info flash page
    [Configuration.h]
2020-05-25 Implemented remote sleep interval configuration
    [Configuration.h]
2020-05-25 Updated flash wipe sketch
    [Configuration.h]
2020-05-25 Set INA260 sensors to power down when not measuring
    [Configuration.h]
2020-05-25 Updated SystemInfoSerial sketch
    [Configuration.h]
2020-05-25 Added camera photo test sketch
    [Configuration.h]
2020-05-26 Changed sensor function naming convention to Sensor_<type>_<function>
2020-05-26 Set temperature sensors to one-shot measurement
    [Configuration.h]
2020-05-26 Set light sensors to power down mode by default
2020-05-26 Set IMU gyroscope to power down by default
2020-05-27 Set shorter response delay interval for flash downlink commands
    [Configuration.h]
2020-05-28 Added variable length of pause between CW beeps based on battery level
2020-05-28 Added FSK mode requirement to IMU recording
2020-05-28 Powered up GPS prior to starting offset timer
2020-05-28 Added FEC to picture downlink
    [Configuration.h]
2020-05-28 Fixed swapped acceleration/angle velocity labels
    [GroundStation.ino]
2020-05-29 Fixed battery voltage beep interval check
    [FossaSat2.ino]
2020-05-29 Set short response delay to 0
    [Configuration.h]
2020-05-29 Reworked IMU recording
2020-05-30 Fixed debug flash print macro
    [Debug.h, GroundStation.ino]
2020-05-30 Added option to only downlink JPEG scan data
    [Configuration.h]
2020-05-30 Set debug flash print to page to suppress cppcheck unsignedLessThanZero
2020-05-30 Added configurable power FET polarity
    [Configuration.h]
2020-05-31 Added Rx mode during flash wipe execution
    [Configuration.h]
2020-05-31 Moved GPS Serial definition to build_opt.h
    [Configuration.h]
2020-05-31 Fixed GPS UART pins definition in build opt
    [Configuration.h]
2020-05-31 Implemented CMD_ABORT
    [Configuration.h]
2020-05-31 Extracted GPS logging into functions
    [Configuration.h]
2020-05-31 Fixed shadowed variable names
    [Configuration.h]
2020-05-31 Added check to prevent freeze when light sensors fail
    [Configuration.h]
2020-05-31 Added check to prevent freeze when current sensor fails
    [Configuration.h]
2020-05-31 Added sensor states to full system info
2020-06-01 Added missing system info flash write
    [FossaSat2.ino]
2020-06-01 Reworked flash map, renamed system info get/set, added generic get/set
    [Configuration.h]
2020-06-02 Reworked directory structure
    [Configuration.h]
2020-06-02 Added parameter to skip sleep in IMU reading
    [Sensors.cpp, Sensors.h]
2020-06-04 Initial ADCS detumbling integration
    [Configuration.h]
2020-06-04 Fix cppcheck out of bounds pointer
    [PersistentStorage.cpp]
2020-06-04 Fix cppcheck duplicate if branch
    [adcs_main.cpp]
2020-06-04 Updated default ADCS parameters
    [Configuration.h]
2020-06-04 Fixed IMU not put back to sleep
    [Sensors.cpp, adcs_main.cpp]
2020-06-04 Fixed ADCS pulse amplitude default value
    [Configuration.h]
2020-06-05 Converted IMU units to IS
    [Configuration.h]
2020-06-05 Added missing ADCS control law calculation
    [Configuration.h]
2020-06-05 Added option to override detumbling tolerance check
    [Configuration.h]
2020-06-05 Replaced GPS logging variables with struct
    [Configuration.h]
2020-06-06 Added ADCS calculation type (float/double)
    [Configuration.h]
2020-06-06 Added detumbling checks for low power and abort command
2020-06-06 Implemented CMD_SET_ADCS_PARAMETERS
    [Configuration.h]
2020-06-06 Implemented public picture frames
    [Configuration.h]
2020-06-07 Add files via upload
    Fixed intensity filter rectifier: the pulse amplitude divisor must be squared to fit physical sense.
2020-06-07 Fixed incorrect ADCS coil characteristics
    [Configuration.h]
2020-06-07 Detumbling update
    The magnetic coil characteristics shall be introduced already inversed to calculate the intensities when this matrix were not diagonal.
    This latter calculation is modified to incorporate this case.
    The magnetic moment calculation is also corrected: the B_module division must be squared.
    The constant gainConstant is also simplified by means of the mean orbital motion.
    [detumbling.cpp]
2020-06-07 Fixed intensities rectifier
    The division of the calculated elapsed energy must be squared to fit the physical sense.
    [intensities_filter.cpp]
2020-06-07 Intensities calculation fixing
    Both the mangetic moment calculation (m) and the intensities one are modified. Magnetic module must be squared, and the intensities calculation incorporates a whole non-diagonal A coil characteristics matrix linear system solving. The A matrix must be introduced already inversed
    [onboardcontrol.cpp]
2020-06-07 Made abort flag volatile
    [Configuration.h]
2020-06-07 Increased debug print resolution
2020-06-07 Inverted coil characteristic matrix
    [Configuration.h]
2020-06-08 Implemented ADCS control of H-bridges
    [Configuration.h]
2020-06-08 Added missing coil char variable
    [Types.h]
2020-06-08 Made H bridge timer parameters configurable
    [Configuration.h]
2020-06-08 Changed internal ADCS units from us to ms
    [Configuration.h]
2020-06-08 Updated system info serial sketch
    [Configuration.h]
2020-06-11 Updated picture upload sketch
    [Configuration.h]
2020-06-11 Updated external flash test sketch
    [Configuration.h]
2020-06-11 Updated flash display sketch
    [Configuration.h]
2020-06-12 Fixed battery heater sketch folder structure
    [BatteryHeaters.ino]
2020-06-12 Updated camera photo test sketch
    [Configuration.h]
2020-06-12 Updated sun sensor test sketch
2020-06-12 Added missing science mode flag for GPS logging
    [Configuration.h]
2020-06-12 Added science flag to ADCS detumbling
    [Configuration.h]
2020-06-22 Renamed B module tolerance ADCS parameter
    [Configuration.h]
2020-06-23 Added new ADCS parameters
    [Configuration.h]
2020-06-23 Reduced B matrix and TOL adding
    kalman_filtering: Matrix B is reduced to simplify the code.
    measure_hybrid: Tolerance added to avoid NaN in computing vectors norm.
    [kalman_filtering.cpp, measure_hybrid.cpp]
2020-06-23 Angles determination through atan2
    The whole angular determination is made by use of the atan2 function, to avoid mis-desambiguation.
    [angles_determination.cpp]
2020-06-24 Implemented rest of ADCS active control
    [Configuration.h]
2020-06-24 Fixed out of bounds access
    [kalman_filtering.cpp, onboardcontrol.cpp]
2020-06-26 Added ADCS result logging
    [Configuration.h]
2020-06-26 Added solar cells output power logging
    [Configuration.h]
2020-06-26 Fixed shadowed variable name
    [Communication.cpp]
2020-06-26 Solar determination update
    solar_determination is updated to account for variable max obtainable power in each solar panel as well as max lux in the sun sensor
2020-06-26 Removed unnecessary ADCS position argument
    [Configuration.h]
2020-06-26 Added ephemerides selection
    [Configuration.h]
2020-06-27 Inverted power FETs switching logic
    [Configuration.h]
2020-06-27 ADCS review
    Onboardcontrol was modified: for loop out of range.
    Typo on kalman_filtering. Gauss-Jordan scheme fixed
    [kalman_filtering.cpp]
2020-06-27 Gauss-Jordan scheme revisited
    Fixed GJ procedure to inverse matrices
    [kalman_filtering.cpp]
2020-06-27 Used RTC timer for Rx window length tracking
2020-06-27 Fixed ephemerides buffer access
    [PersistentStorage.cpp]
2020-06-28 Converted power to watts
2020-06-28 Fixed default max solar panels power units
    [Configuration.h]
2020-06-28 Added ADCS NaN tolerance function
    [adcs.h, adcs_main.cpp, detumbling.cpp, eclipse_hybrid.cpp, euler_integrator.cpp, kalman_filtering.cpp, measure_hybrid.cpp, onboardcontrol.cpp]
2020-06-29 kalman_filtering update
    kalman_filtering is updated to implement a pivoting algorithm to avoid NaN in the GJ scheme
    [kalman_filtering.cpp]
2020-06-29 Constants and Macro review
    More accurate constants update
    [Configuration.h]
2020-06-29 kalman_filtering review and Macros update
    Typos corrected, as well as code simplifying.
    Divisions by 0 are avoided by the use of the pivoting algorithm
    [Configuration.h]
2020-06-29 Fixed array elements addressing
    [kalman_filtering.cpp]
2020-06-29 Fixed intensities_filter
    Fixed signed output in intensities_filter
    [intensities_filter.cpp]
2020-06-29 Added configurable inertia tensor matrix
    [Configuration.h]
2020-06-30 Implemented magnetorquer pulse direction
2020-07-02 Constants review
    Inertia tensor dimensions are modified and the Panel_Unit_Vector is implemented in the luxData order
    [Configuration.h]
2020-07-02 Some variables definitions
    Variables declaration which were not provided are now implemented. Some typos are also corrected
    [angles_determination.cpp, intensities_filter.cpp, rotation_verification.cpp]
2020-07-02 Fixed inertia tensor dimensions
    [Configuration.h]
2020-07-03 Constants review
    The inverse of the inertia tensor has been introduced.
    Max_intensity constan is reviewed, as well as min_inertial_moment
    [Configuration.h]
2020-07-04 Lux data modification
    Vector lux_data order is modified. The panel_unit vector also is.
    [Configuration.h]
2020-07-04 Fixed calls to sensors
    [ads_main.cpp]
2020-07-04 Fixed ADCS control vector size and update
    [Types.h, acs.h, adcs_main.cpp, onboardcontrol.cpp]
2020-07-04 Added option to disable FSK-only packets
    [Configuration.h]
2020-07-06 Update for RadioLib 4.0.0
    [Configuration.h]
2020-07-06 Updated ground station demo for RadioLib 4.0.0
2020-07-06 ADCS Review
    Two possible typos are corrected, concerning updating variables between iterations.
    [adcs_main.cpp]
2020-07-07 ADCS review
    Eclipse threshold is modified to account for a 20% output of the solar panels out of its maximum. Eclipse_decision function is modified to avoid using the solar sensor data.
    Solar ephemerides in solar_determination are now normalized.
    Active control updating between iterations is revised: intensities were not saved.
    Variables names in onboardcontrol are changed to be consistent all along the system (stateVars)
    [Configuration.h]
2020-07-09 controlLaw, eulerAnglesMatrix initialization
    controlLaw initialization is corrected in onboardcontrol.ccp
    eulerAnglesMatrix is now initialized every iteration.
    [measure_hybrid.cpp, onboardcontrol.cpp]
2020-07-09 New reference frames changes
    inertia tensor is rearranged to match new reference frames.
    calling the solar instruments now match the new nominal nadir referecence frame
    [Configuration.h]
2020-07-09 Instruments commanding
    Instruments are now commanded to follow the new reference frame
2020-07-09 Corrected typo
    Swap luxData commanding has been fixed
    [ads_main.cpp]
2020-07-09 Fixed max power vector reference frame
    [solar_determination.cpp]
2020-07-09 Removed old max power vector reading
2020-07-09 Fixed pulse lengths vector reference frame
    [adcs_main.cpp]
2020-07-10 Eclipse_decision update
    Eclipse_decision is modified to avoid commanding the solar sensor
    [ads_main.cpp]
2020-07-10 Implemented CMD_SET_IMU_OFFSET
    [Configuration.h]
2020-07-10 detumbling update
    Detumbling routine is simplified, as the b-dot algorithm simply acts on the needed magnetic moment
2020-07-10 Negative feedback loop controller
    Corrected sign in the active control law to account for a negative feedback loop control system
    [onboardcontrol.cpp]
2020-07-11 Constants update
    Constants update
    [Configuration.h]
2020-07-11 Constants update
    Inertia tensor inverse is revised.
    Coil characteristics are also revised in the new reference frame.
    [Configuration.h]
2020-07-12 Added missing ADCS placeholder parameters
    [Configuration.h]
2020-07-12 Updated camera test sketch
    [Configuration.h]
2020-07-12 Updated picture upload test sketch
    [Configuration.h]
2020-07-12 Updated system info test sketch
    [Configuration.h]
2020-07-12 Updated output power test sketch
2020-07-12 Fixed missing separate LoRa/GFSK frequency
    [OutputPower.ino]
2020-07-12 Implemented IMU calibration transformation
    [Configuration.h]
2020-07-13 Active omega tolerance update
    Active omega tolerance is revised to account for a more precise and real performance
    [Configuration.h]
2020-07-13 Intensity parameters at the H-bridges
    Max applicable intensity as well as average nominal intensity applied are defined
    [Configuration.h]
2020-07-14 ADS review
    In solar determination, body frame ephemerides are normalized in a simpler way, calling for tolerance adding only once.
    In measure_hybrid, calling for tolerance adding is only done once.
    Ads_main arguments are revised and made constant.
    [ads.h, ads_main.cpp, measure_hybrid.cpp, solar_determination.cpp]
2020-07-14 Tolerance reaching
    Active tolerance reaching structure is modified to accomplish a safest performance (less unstabilizing)
    [Configuration.h]
2020-07-14 Measure_hybrid typo correction
    Measurements values are now initialized
    [measure_hybrid.cpp]
2020-07-14 Fixed solar reference frame conversion
    [adcs_main.cpp]
2020-07-15 kalman_filtering correction
    The structure is revised and correctly idented
    [kalman_filtering.cpp]
2020-07-21 Measure mixing update
    measure_hybrid is modified to avoid a singular ephemerides matrix using the classical TRIAD algorithm
    [measure_hybrid.cpp]
2020-07-21 Constants update
    Relevant constants for the ADCS system are revised.
    [Configuration.h]
2020-07-22 Fixed incorrect comment about reference frames (#27)
    [adcs_main.cpp]
2020-07-23 Kalman Filter update
    Auxiliary loops are unnested to prevent overlapping between the two.
    The algorithm is revised and an error is fixed concerning the general flow
    [kalman_filtering.cpp]
2020-07-23 Fixed system info load on startup
    [FossaSat2.ino]
2020-07-23 Fixed default macro configuration
    [Configuration.h]
2020-07-24 Constants Update
    Detumbling omega_tolerance is modified to provide a more zero-state converged detumbling.
    Active omega_tolerance is modified to provide a less tight active controlling performance
    [Configuration.h]
2020-07-24 Noise update
    Noise covariances are updated to provide a more preliminar stable behaviour in the Kalman Filter performance
    [Configuration.h]
2020-07-25 Panel matrix
    The unit vector matrix containing the directions in the body frame of the panels is now introduced in pseudo-inverse form.
    [Configuration.h]
2020-07-25 Fixed solar panel vector matrix dimensions
    [Configuration.h]
2020-07-26 Configuration Update
    Num controllers is revised, as well as rotation trigger.
    [Configuration.h]
2020-07-26 Changed MPPT pin to Hi-Z enable
2020-07-27 Kalman filter arguments status
    All Kalman Filter passing arguments dimensions are now completely specified.
2020-07-27 Constants update
    Constants are revised and the first controller matrix is implemented.
    [Configuration.h]
2020-07-27 Increased maximum allowed number of AES128 blocks
    [Configuration.h]
2020-07-27 Fixed incorrect opt data len for CMD_SET_IMU_CALIBRATION
    [Communication.cpp]
2020-07-27 Added missing CMD_SET_IMU_CALIBRATION implementation
    [Communication.cpp]
2020-07-27 Fixed voltage unit in system info
    [Communication.cpp]
2020-07-27 Fixed voltage unit in stats
    [PersistentStorage.cpp]
2020-07-27 Fixed incorrect control vector size
    [ads.h, ads_main.cpp]
2020-07-27 Added stats reset to RESET_SYSTEM_INFO
    [FossaSat2.ino]
2020-07-28 Fixed CW beep voltage unit
    [FossaSat2.ino, PowerControl.cpp]
2020-07-28 Fixed typo in GPS power fet
    [Configuration.h]
2020-07-28 Set magnetometer scale in test sketch to 16 gauss
2020-07-28 Fixed ephemerides parameter size
    [ads.h, ads_main.cpp]
2020-07-28 Set magnetometer scale to 16 gauss
2020-07-28 Fixed flash stats constants
    [PersistentStorage.cpp]
2020-07-28 Fixed debug macro params
    [Debug.h]
2020-08-23 Fixed errors in ground station sketch (#32)
    [GroundStation.ino]
2025-07-14 ADCS Gerber Upload
2025-07-14 Internal Stack Gerber Upload
2025-07-14 Solar Panel Gerber Upload
2025-07-14 EPS Gerber Upload
2025-07-14 OBC Gerber Upload
2025-07-14 Antenna Gerber Upload
